jaywebb67/ELEC520_Group2/Gate_Node_2.0/Gate_Node_2.0.ino

/*
 *ELEC_520 
 *authored by Alex Meredith, and Jay Webb
*/ 

#include <Wire.h>
#include "I2C_LCD.h"
#include "LCD_Manager.h"
#include "MQTT.hpp"
#include "driver/uart.h"
#include "driver/gpio.h"
//#include "Communication_Protocol.h"

#define DEVICE_NAME "Gate 1"
#define I2C_SLAVE_ADDRESS 0x03 // Address of the slave device
#define SDA_2 5 
#define SCL_2 0
#define YellowPin   14



struct TX_Q {
  //const struct TX_Payload* message;
  struct TX_Payload* message;
  uint8_t dest;
};

struct TX_Q TXbuff_0;
struct TX_Q TXbuff_1;
struct TX_Payload No_User_Cmd = {6, "NVuser"};

//ESP32 WROOM pins
const int rowPins[4] = {18, 19, 13, 32};     // Row pins connected to the keypad
const int colPins[4] = {23, 12, 26, 27};     // Column pins connected to the keypad

char Input_Key_Code[7];
char Start_Pass[7] = {"012345"};
//const char User_Cmd[6] = "Vuser";
struct TX_Payload User_Cmd = {5, "Vuser"};
//const char No_User_Cmd[7] = "NVuser";
char receivedCode[7];
bool codeReceived = false;
uint8_t response = 1;
volatile uint32_t counter = 0;
volatile unsigned char buffer[MESSAGE_LENGTH];
volatile unsigned char bufferIndex = 0;
volatile uint32_t bytes_Received = 0;
unsigned long debounceDelay = 250;        // Debounce time in milliseconds
volatile uint8_t Valid_Input_Presses = 0;
volatile unsigned long lastInterruptTime = 0;
volatile bool isPressed = false;
uint32_t buffno;
bool alarmEnabled = true;
char newNodePayload[34];
char firePing[32] ;
char intrusionPing[32];
// Define task handles
TaskHandle_t Keypad_Reader = NULL;
TaskHandle_t Bluetooth_Task_Handle = NULL; // Task handle for Bluetooth task
TaskHandle_t LCD_Thread_Handle;
//TaskHandle_t RX_Message_Handle;
TaskHandle_t TX_Message_Handle;
QueueHandle_t RX_Queue;
TaskHandle_t RX_Message_Handle;
QueueHandle_t TX_Queue;
// Timer handle 
TimerHandle_t Keypad_Timeout_Timer;


// Timer callback function 
void TimeoutCallback(TimerHandle_t xTimer) { 
  Serial.println("Timeout occurred. Resetting Valid_Input_Presses."); 
  Valid_Input_Presses = 0; 
  Send_To_LCD_Queue(T_Out);
  Send_To_LCD_Queue(Enter_Mess);
}

// ISR for multi thread applications
void IRAM_ATTR onUartRx() {
  BaseType_t xHigherPriorityTaskWoken = pdFALSE;
  char data = RS485Serial.read(); // Read data from HardwareSerial
  //Serial.println("RX ISR");
  
  if (bufferIndex < 40) {
    buffer[bufferIndex++] = data;

    // Check if the full message is received
    if (bufferIndex == MESSAGE_LENGTH || data == END_BYTE) {
      xQueueSendFromISR(RX_Queue, (const void*)buffer, &xHigherPriorityTaskWoken); // Cast buffer to const void*
      bufferIndex = 0; // Reset buffer index for the next message
    }
  }

  if (xHigherPriorityTaskWoken) {
    portYIELD_FROM_ISR();
  }
}

//alternative keypad ISR more stable but wrong in every way
void IRAM_ATTR Key_Pressed_ISR() {
  unsigned long interruptTime = millis();
  // Debounce logic
  if ((interruptTime - lastInterruptTime > debounceDelay) && !isPressed) {
    isPressed = true;
    //keypresses++;
    BaseType_t xHigherPriorityTaskWoken = pdFALSE;
    vTaskNotifyGiveFromISR(Keypad_Reader, &xHigherPriorityTaskWoken);
    portYIELD_FROM_ISR(xHigherPriorityTaskWoken); // Perform a context switch if needed
  }
  lastInterruptTime = interruptTime;
}

void BluetoothDataReceived(int howMany) {
  Serial.print("I2C received: ");
  int i = 0;
  while (Wire.available() && i < 6) {
    receivedCode[i] = Wire.read();
    Serial.print(receivedCode[i]); // Print each received character
    i++;
  }
  receivedCode[i] = '\0'; // Null-terminate the string
  Serial.print(" Complete code: ");
  Serial.println(receivedCode); // Print the complete code
  codeReceived = true;
  // Notify the Bluetooth task
  BaseType_t xHigherPriorityTaskWoken = pdFALSE;
  vTaskNotifyGiveFromISR(Bluetooth_Task_Handle, &xHigherPriorityTaskWoken);
  portYIELD_FROM_ISR(xHigherPriorityTaskWoken); // Perform a context switch if needed
  
}
void Process_BT_Message(void *pvParameters) {
  while (true) {
    // Wait for the notification from ISR 
    ulTaskNotifyTake(pdTRUE, portMAX_DELAY);
    Serial.println("BT task entered");

    if (codeReceived) {
      Serial.println("Checking code");
      codeReceived = false;
      response = Test_Entry_Code(receivedCode); // Check the received code and set the response
      Serial.print("TEC response: ");
      Serial.println(response);
    }
  }
}
void requestEvent() {
  Serial.print("I2C request. Response: ");
  Serial.println(response);
  Wire.write(response);
  //response = '\0';
}

void notify_User(int x) {
  switch (x) {
    case 1:
      Send_To_LCD_Queue(Access_D);
      break;
    case 2:
      Send_To_LCD_Queue(Access_G);
      break;
    case 3:
      Send_To_LCD_Queue(Bye);
      break;
    default:
      Send_To_LCD_Queue(Broken);
      break;
  }
  Send_To_LCD_Queue(Enter_Mess);
}

int Test_Entry_Code(const char* code) {
  int x = Valid_Entrance_Codes.searchEntry(code);
  if (x < 0) {
    Serial.println("Access Denied");
    return 1;
  } 
  else {
    // Get the username corresponding to the code
    String username = Valid_Entrance_Codes.findUsername(x);
    if (username.isEmpty()) {
      Serial.println("Error retrieving username.");
      return -1; // Error case
    }

    // Format "username:password" pair
    const int formattedLength = username.length() + 1 + strlen(code) + 1; // username + ':' + code + '\0'
    char* formattedEntry = new char[formattedLength];
    snprintf(formattedEntry, formattedLength, "%s:%s", username.c_str(), code);

    // Check if the code is already in use
    x = Current_Codes_In_Use.searchEntry(code);
    if (x < 0) {
      Serial.println("Access Granted");
      Current_Codes_In_Use.addEntry(formattedEntry); // Add the formatted "username:password" pair
      delete[] formattedEntry; // Free memory for the formatted entry
      Current_Codes_In_Use.printBuffer();

      // Prepare MQTT message
      MqttMessage msg;
      msg.topic = "ELEC520/userAccess";
      msg.payload = username;
      //delete[] username;
      // Send the message to the queue
      if (xQueueSend(mqttPublishQueue, &msg, portMAX_DELAY) != pdPASS) {
        Serial.println("Failed to send message to MQTT queue");
      }
      if((Current_Codes_In_Use.getCurrentIndex()==0)){
        MqttMessage msgAlarm;
        msgAlarm.topic = "ELEC520/alarm";
        msgAlarm.payload = "Alarm Disabled";

        Transmit_To_Bus(&User_Cmd);
        Serial.println("Valid user in");
        // Send the message to the queue
        if (xQueueSend(mqttPublishQueue, &msgAlarm, portMAX_DELAY) != pdPASS) {
          Serial.println("Failed to send message to MQTT queue");
        }
        alarmEnabled = false;
      }
      return 2;
    } 
    else {
      delete[] formattedEntry; // Free memory for the formatted entry
      Serial.println("Exit Goodbye");
      Current_Codes_In_Use.deleteEntry(x); 
      Current_Codes_In_Use.printBuffer();
      // Prepare MQTT message
      MqttMessage msg;
      msg.topic = "ELEC520/userAccess";
      msg.payload = username;
      //delete[] username;
      // Send the message to the queue
      if (xQueueSend(mqttPublishQueue, &msg, portMAX_DELAY) != pdPASS) {
        Serial.println("Failed to send message to MQTT queue");
      }
      if((Current_Codes_In_Use.getCurrentIndex()<0)){
        MqttMessage msgAlarm;
        msgAlarm.topic = "ELEC520/alarm";
        msgAlarm.payload = "Alarm Enabled";
        Transmit_To_Bus(&No_User_Cmd);
        Serial.println("No valid user");
        // Send the message to the queue
        if (xQueueSend(mqttPublishQueue, &msgAlarm, portMAX_DELAY) != pdPASS) {
          Serial.println("Failed to send message to MQTT queue");
        }
        alarmEnabled = true;
      }
      return 3;
    }
  }
}



// Task 1 function 
void Keypad_Read(void *pvParameters) {
  
  
  unsigned long Start_Time;

  // Create the timeout timer (10 seconds) 
  Keypad_Timeout_Timer = xTimerCreate("TimeoutTimer", pdMS_TO_TICKS(10000), pdFALSE, 0, TimeoutCallback);

  // Keypad layout (row-major order)
  char keypad[4][4] = {
    {'1', '2', '3', 'A'},
    {'4', '5', '6', 'B'},
    {'7', '8', '9', 'C'},
    {'*', '0', '#', 'D'}
  };
  int pressedRow = -1;  // Row where the key press occurred
  int pressedCol = -1; // Column where the key press occurred
  bool multipleKeysPressed = false; // Flag for multiple key presses

  while (true) {
    ulTaskNotifyTake(pdTRUE, portMAX_DELAY); //wait for flag

    isPressed = true;
    //vTaskDelay(pdMS_TO_TICKS(debounceDelay));
   
    Serial.println("Entering task 1.");
   
    for (int i = 0; i < 4; i++) {
      //set row pins high to enable reading
      digitalWrite(rowPins[i], HIGH); // Reset rows to HIGH (idle state)
    }
   
    // Scan for key press in all rows and columns
    int pressedCount = 0;
    int foundRow = -1;
    int foundCol = -1;

    //Scan all rows and columns to determine which key was pressed
    for (int row = 0; row < 4; row++) {
      digitalWrite(rowPins[row], LOW); // Activate current row

      for (int col = 0; col < 4; col++) {
        if (digitalRead(colPins[col]) == LOW) {
          pressedCount++;
          foundRow = row;
          foundCol = col;
          // Serial.print("Row: ");
          // Serial.print(foundRow);
          // Serial.print("Column: ");
          // Serial.println(foundCol);
        }
      }

      digitalWrite(rowPins[row], HIGH); // Deactivate row
    }

    // Process single or multiple key presses 
    if (pressedCount > 1) { 
      //Send_To_LCD_Queue(Invalid_Mess);
      Serial.println("Multiple keys detected, rejecting input."); 
    } 
    else if (pressedCount == 1) 
    { char key = keypad[foundRow][foundCol]; // Set the key 
    Input_Key_Code[Valid_Input_Presses] = key; 
    if(Valid_Input_Presses == 0){
      xTimerStart(Keypad_Timeout_Timer, 0);
    }
    Valid_Input_Presses++; 
    Serial.print("Key pressed: "); 
    Serial.println(key);

      if(Valid_Input_Presses == 6){
        // Process the valid 6-byte code
        int y = Test_Entry_Code(Input_Key_Code);
        if(buffno==0){
          Transmit_To_Bus(&User_Cmd);
        }
        else if (buffno < 0){
          Transmit_To_Bus(&No_User_Cmd);
        }
        notify_User(y);
        Serial.println(y);
        Serial.println(Input_Key_Code);
        Valid_Input_Presses = 0;
        xTimerStop(Keypad_Timeout_Timer, 0);
        //Send_To_LCD_Queue(Enter_Mess);
      }
    }
    // Reset row pins to low to reenable the interrupt
    for (int i = 0; i < 4; i++) {
      //attachInterrupt(digitalPinToInterrupt(colPins[i]), Key_Pressed_ISR, FALLING);
      digitalWrite(rowPins[i], LOW); // Reset rows to LOW for interrupt to work
    }
    // Reset pressed flag 
      isPressed = false;

      
  }
}

// RS485 serial port task
void RX_Message_Process(void *pvParameters) {
  unsigned char receivedMessage[MESSAGE_LENGTH];
  while (1) {
    if (xQueueReceive(RX_Queue, &receivedMessage, portMAX_DELAY)) {
      memset(RX_Message_Payload, 0, sizeof(RX_Message_Payload));
      Addressee = Decode_Message(receivedMessage, &Sender_Address, &Sender_Node_Type, RX_Message_Payload);
      // Process received message

      // Serial.print("Sent from node of type: ");
      // Serial.println(Sender_Node_Type);

      if((Addressee == MQTT_Address) && (I_am_Forwarder)) {
        // Create an MQTT message structure
        MqttMessage mqttMessage;

        // Assign topic based on the received message type (example logic, adjust as needed)
        if (strncmp((const char*)RX_Message_Payload, "Intro", 5) == 0) {
            Serial.println("New node detected. Configuring...");
                // Format payload for the new node
            snprintf(newNodePayload, sizeof(newNodePayload), "Intro:%02X", Sender_Node_Type);
            mqttMessage.topic = "ELEC520/devices/view";
            mqttMessage.payload = newNodePayload;
        } 
        // else if (strcmp((const char*)RX_Message_Payload, "23.53") == 0){
        //     mqttMessage.topic = "ELEC520/temperature";
        //     // Assign the payload from RX_Message_Payload
        //     mqttMessage.payload = String((char*)RX_Message_Payload);

        // } 
        else if (Sender_Node_Type == Fire_Node) {  // Example: Fire sensor type
            if(strncmp((const char*)RX_Message_Payload, "Fire online", 11) == 0){
                mqttMessage.topic = "ELEC520/devicePing";
                snprintf(firePing, sizeof(firePing), "Fire online %02X", Addressee);
                mqttMessage.payload = firePing;
            }
            else{
                mqttMessage.topic = "ELEC520/temperature";
                // Assign the payload from RX_Message_Payload
                mqttMessage.payload = String((char*)RX_Message_Payload);
            }
        } else if (Sender_Node_Type == Intrusion_Node) {  // Example: Temperature node type
            if(strncmp((const char*)RX_Message_Payload, "Intrusion online",16) == 0){
              mqttMessage.topic = "ELEC520/devicePing";
              snprintf(intrusionPing, sizeof(intrusionPing), "Intrusion online %02X", Addressee);
              mqttMessage.payload = intrusionPing;
            }
          
            else{
                mqttMessage.topic = "ELEC520/imu";
                // Assign the payload from RX_Message_Payload
                mqttMessage.payload = String((char*)RX_Message_Payload);
            }
        } else {
            mqttMessage.topic = "Home/Unknown";  // Default topic for unclassified nodes
            // Assign the payload from RX_Message_Payload
            mqttMessage.payload = String((char*)RX_Message_Payload);
        }
        // Send the MQTT message to the queue
        if (xQueueSend(mqttPublishQueue, &mqttMessage, portMAX_DELAY) != pdPASS) {
            Serial.println("Failed to send message to MQTT queue");
        }
      }
      // else if(Addressee == Home_Address){
      //   uint8_t temp = Destination_Address;
      //   Destination_Address = Intrusion_Node;
      //   struct TX_Payload msg;
      //   if(strcmp((const char*)RX_Message_Payload, "Alarm Enabled") == 0){
      //     msg = {7,"NVuser"};
      //   }
      //   if(strcmp((const char*)RX_Message_Payload, "Alarm Disabled") == 0){
      //     msg = {6,"Vuser"};
      //   }
      //   Transmit_To_Bus(&msg);
      //   Destination_Address = temp;
      // }
      


      // Serial.print("Received message: ");
      // for (int i = 0; i < MESSAGE_LENGTH; i++) {
      //   Serial.print(receivedMessage[i], HEX);
      //   Serial.print(" ");
      // }
      // Serial.println();
      // Serial.println((char*)RX_Message_Payload);
    }
  }
}

// Task 4 function
void LCD_Thread(void *pvParameters) {
  QueueItem item; 
  while (1) { 
    if (xQueueReceive(LCD_Queue, &item, portMAX_DELAY)) { 
      // Call the function 
      item.func(); 
    } 
    // sleep for 2 seconds as minimum LCD display time 
    vTaskDelay(pdMS_TO_TICKS(2000));
  }
}

void TX_Message_Process(void *pvParameters) {
  struct TX_Q receivedMessage;
  while (1) {
    if (xQueueReceive(TX_Queue, &receivedMessage, portMAX_DELAY)) {
        uint8_t temp = Destination_Address;
        Destination_Address = receivedMessage.dest;
        Transmit_To_Bus(receivedMessage.message);
        Destination_Address = temp;
    }
  }
}
void receiveEvent(int howMany) {
  Serial.print("I2C received: ");
  int i = 0;
  while (Wire.available() && i < 6) {
    receivedCode[i] = Wire.read();
    Serial.print(receivedCode[i]); // Print each received character
    i++;
  }
  receivedCode[i] = '\0'; // Null-terminate the string
  Serial.print(" Complete code: ");
  Serial.println(receivedCode); // Print the complete code
  codeReceived = true;
}

void setup() {
 // Start Serial communication
  Serial.begin(9600);
  //call function to set up correct communication pins and serial port for the board in use
  Comms_Set_Up();
  Serial.println("Hello");
  pinMode(YellowPin, OUTPUT);
  digitalWrite(YellowPin, LOW);
  MQTT_SetUp();
  Wire.begin(I2C_SLAVE_ADDRESS);  // Initialize the I2C bus as a slave
  Wire.onReceive(BluetoothDataReceived);   // Register the receive event handler
  //Wire.onReceive(receiveEvent);   // Register the receive event handler
  Wire.onRequest(requestEvent);   // Register the request event handler
  // Initialize queue
  // Initialize I2C as master for LCD 
  Wire1.begin(SDA_2, SCL_2); // Initialize the I2C bus as a master

  // Initialize the LCD
  // lcd.begin();
  // lcd.backlight(); // Turn on the backlight
  // lcd.print("Hello, World!"); // Print a test message

  LCD_Innit();
  

  

  
   RX_Queue = xQueueCreate(10, MESSAGE_LENGTH * sizeof(char));
   TX_Queue = xQueueCreate(10, sizeof(TX_Q));
   LCD_Queue = xQueueCreate(10, sizeof(QueueItem));
  
  // Create Task 1 (runs on Core 0 by default)
  xTaskCreatePinnedToCore(
    Keypad_Read,               // Task function
    "Keypad_Read",            // Task name
    10000,               // Stack size (bytes)
    NULL,                // Parameters passed to the task
    3,                   // Task priority (higher is higher priority)
    &Keypad_Reader,        // Task handle
    0                    // Core 0
  );
  
  // Initialize row & column pins 
  for (int i = 0; i < 4; i++) {
    pinMode(rowPins[i], OUTPUT);
    digitalWrite(rowPins[i], LOW);  // Keep rows LOW initially (inactive)
    pinMode(colPins[i], INPUT_PULLUP);
  }
   // Set up interrupts on the column pins to detect a key press
  for (int i = 0; i < 4; i++) {
    attachInterrupt(digitalPinToInterrupt(colPins[i]), Key_Pressed_ISR, FALLING);
  }

  //put in initial value for testing
  Valid_Entrance_Codes.addEntry(Start_Pass);
  Valid_Entrance_Codes.printBuffer();
  // Create Task 2 (runs on Core 0)
  xTaskCreatePinnedToCore(
     Process_BT_Message,        // Function to implement the task
    "Process_BT_Message",     // Name of the task
    10000,                    // Stack size in words
    NULL,                     // Task input parameter
    3,                        // Priority of the task
    &Bluetooth_Task_Handle,   // Task handle
    0                         // Core where the task should run
  );

  // Create task 3 (rus on core 0)
  xTaskCreatePinnedToCore(
     RX_Message_Process,  // Task function. 
    "RX_Message_Process",     // name of task. 
    10000,                    // Stack size of task 
    NULL,                     // parameter of the task 
    2,                        // priority of the task 
    &RX_Message_Handle,      // Task handle to keep track of created task 
    0                         // pin task to core 0 
    );                       

  // Create task 4 (runs on core 0)
  xTaskCreatePinnedToCore(
     LCD_Thread,            //Task function
    "LCD_Thread",               //name of task
    10000,                      //stacksize of task
    NULL,                       //parameter of task
    1,                          //priority of task
    &LCD_Thread_Handle,                //Task handle to keep track of created task 
    0                           //pin task to core 0
  );

  xTaskCreatePinnedToCore(
     TX_Message_Process,  // Task function. 
    "TX_Message_Process",     // name of task. 
    10000,                    // Stack size of task 
    NULL,                     // parameter of the task 
    1,                        // priority of the task 
    &TX_Message_Handle,      // Task handle to keep track of created task 
    1                         // pin task to core 1
    );                       
 

  // Attach UART interrupt 
  RS485Serial.onReceive(onUartRx); // Attach the interrupt handler

  Enter_Mess();

  xTaskCreatePinnedToCore(MQTT_task, "MQTT_task", 5000, NULL, 1, &mqttTaskHandle, 1);
  if (mqttTaskHandle == NULL) {
      Serial.println("Failed to create mqtt thread.");
  } else {
      Serial.println("MQTT thread task created successfully.");
  }
  digitalWrite(YellowPin, HIGH);

}

void loop() {
  // put your main code here, to run repeatedly:

}
