jaywebb67/ELEC520_Group2/(commit log)

2024-09-29 MQTT Nucleo Code
    MQTT code for sending potentiometer value for support board and data displayed as graph on streamsheets
2024-10-15 ESP32 - Keypad, LCD display
2024-10-30 Add keypad and MQTT ESP32 Client
    Checks keypad entry against user credentials stored in a text file
2024-11-01 Improve MQTT
    on connection check database for device ID. Also gets users and passwords from database on connection
    When correct password is entered msg on topic 'ELEC520/alarm' is published. Used to communicate with other esp32 device 'alarm'
2024-11-05 node red flow update
2024-11-18 Dashboard
    Dashboard, containing database client code handling the stuff originally on node-red. Everything containerized within a docker container. A few things left to add for the mqtt such as last will message, handling of the deviceStatus, displaying last ping of the device to show whether a device is connected or not; and userAccess to see what user accessed what gate and when
2024-11-22 copy over alarm node and insert comms files
2024-11-25 Improved dashboard and gate code
    Added device config to admin section
    Automatically generate unique 6-digit gate code when user is created - checks against current codes in database
    Add button for users to receive gate code
    Websocket connection to MQTT broker client side, responsible for populating the charts with data received via MQTT
    Added user access log functionality, updates room so if room gate is accessed twice, room is removed from user access log, if gate is of gateType 'entrance' on 2nd access it'll remove user entry from database/table i.e simulating user leaving the building
    Changed MQTT database client so when a message received on 'ELEC520/users/view', users are sent only to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
2024-11-26 fix bt task, and tweak lcd timings and clearing
    [Gate_Node_2.0.ino]
2024-11-29 pwm test code
2024-11-30 Bluetooth I2C module working and tested
2024-12-01 set up I2C link for bluetooth device, and data handling functions. Remove bluetooth functionality from code
2024-12-02 add status led
2024-12-02 Add status leds, and keypad admin access
2024-12-03 updatedTerminal
    terminal updated to improve user creation room adder. Added a show rooms button
2024-12-03 replace communication protocol files
    [Communication_Protocol.cpp, Communication_Protocol.h, Gate_Node_2.0.ino]
2024-12-04 update comms receiver, take out motion detector as too sensetive, imu dead and removed
2024-12-05 Improve MQTT and set up etc
    • Synchronous disabling of alarm: Disable alarm from dashboard. Ensure if disabled on ESP32, it disables the alarm on the dashboard
    • Send admin codes to alarm node and store in buffer and file
    • Device config from dashboard
    • Elect leader for forwarding messages: policy chooses randomly out of selected alarm nodes, due to less onboard processing. If unavailable choose a random available gate node
    • On setup publish message to see if update of users is required, add users to buffer from file initially – if update required, perform code that already initialises, improving set up time. Repeat for admin users
    [deviceConfig.txt]
2024-12-06 Start to add new node config
    [deviceConfig.txt]
2024-12-07 Add device config for nano nodes
    add device config for nano nodes - if device is forwarder it publishes the new deviceID and address to the bus to the default address of the new node type i.e. fire or intrusion. Updates the local values - commented out?
2024-12-07 Add ping for nano devices
2024-12-08 Ping and temperature
    Ping working for nano devices and temperature publishing
2024-12-11 spring clean
